Echo-RWN/RM_Guided_Dart/RM_Guided_Dart_Base_HW-SMT/RM_Guided_Dart_Base_HW-BOM.csv

 | Sourced | Placed | References | Value | Footprint | Quantity
1 |  |  | C5, C6, C12, C14, C15, C18, C19, C20, C24, C26, C31, C41, C42, C43, C45, C46, C47 | 100nF | C_0402_1005Metric | 17
2 |  |  | C11, C13, C16, C21, C22, C32, C33, C34, C38, C39, C40, C44 | 10uF | C_0603_1608Metric | 12
3 |  |  | C9, C10, C27, C28 | 22u | C_0603_1608Metric | 4
4 |  |  | C1, C2, C17 | 4.7u | C_0603_1608Metric | 3
5 |  |  | C35, C36, C37 | 22nF | C_0402_1005Metric | 3
6 |  |  | C3, C4 | 470n | C_0402_1005Metric | 2
7 |  |  | C7, C8 | 10n | C_0402_1005Metric | 2
8 |  |  | C29, C30 | 47uF | C_1206_3216Metric | 2
9 |  |  | C23 | 8.2nF | C_0402_1005Metric | 1
10 |  |  | C25 | 60pF | C_0402_1005Metric | 1
11 |  |  | R30, R32, R34, R35, R36, R37, R38, R41, R44 | 10k | R_0402_1005Metric | 9
12 |  |  | R1, R2, R3, R5, R7 | 33R | R_0402_1005Metric | 5
13 |  |  | R8, R9, R25, R27 | 100k | R_0402_1005Metric | 4
14 |  |  | R17, R39, R40 | 4.7k | R_0402_1005Metric | 3
15 |  |  | R18, R19, R20 | 50k | R_0402_1005Metric | 3
16 |  |  | R4, R23 | 1k | R_0402_1005Metric | 2
17 |  |  | R6, R42 | 33R | R_0603_1608Metric | 2
18 |  |  | R14, R16 | 5k | R_0402_1005Metric | 2
19 |  |  | R21, R22 | 300mR | R_0805_2012Metric | 2
20 |  |  | R10 | 200k±0.1% | R_0402_1005Metric | 1
21 |  |  | R11 | 27K±0.1% | R_0402_1005Metric | 1
22 |  |  | R12 | 68k±0.1% | R_0402_1005Metric | 1
23 |  |  | R13 | 15K±0.1% | R_0402_1005Metric | 1
24 |  |  | R15 | 24k/6.8k | R_0402_1005Metric | 1
25 |  |  | R24 | 3R | R_0402_1005Metric | 1
26 |  |  | R26 | 22k | R_0402_1005Metric | 1
27 |  |  | R28 | 50mR | R_0805_2012Metric | 1
28 |  |  | R29 | 11k | R_0402_1005Metric | 1
29 |  |  | R31 | 80k | R_0402_1005Metric | 1
30 |  |  | R33 | 20k | R_0402_1005Metric | 1
31 |  |  | R43 | 0R | R_0603_1608Metric | 1
32 |  |  | L1, L2 | 10uH | L_Changjiang_FTC303020D | 2
33 |  |  | L3 | 10uH | L_APV_APH0630 | 1
34 |  |  | L4 | 3.3uH | L_APV_APH0630 | 1
35 |  |  | D1, D2, D4 | G | LED_0402_1005Metric | 3
36 |  |  | D5, D6 | R | LED_0402_1005Metric | 2
37 |  |  | D3 | SS54 | D_SMA | 1
38 |  |  | D7 | SS34 | D_SMA | 1
39 |  |  | D8 | BV03C | D_SOD-323 | 1
40 |  |  | U3, U4 | SY8303AIC | TSOT-23-8 | 2
41 |  |  | U1 | LicheeRV_Nano | LicheeRV_Nano_THT | 1
42 |  |  | U2 | XIAO-ESP32-C5-DIP | XIAO-ESP32-C5-SMD | 1
43 |  |  | U5 | CH224Q | DFN-10-1EP_2x2mm_P0.4mm_EP0.9x1.5mm | 1
44 |  |  | U6 | TP5100 | QFN-16-1EP_4x4mm_P0.65mm_EP2.1x2.1mm_ThermalVias | 1
45 |  |  | U7 | TPS54620RHLR | VQFN-14_L3.5-W3.5-P0.50-TL-EP_TPS54620RHLR | 1
46 |  |  | U8 | RT9193-18GB | SOT-23-5 | 1
47 |  |  | U9 | RT9193-15GB | SOT-23-5 | 1
48 |  |  | U10 | RT9193-28GB | SOT-23-5 | 1
49 |  |  | U11 | BMI088 | Bosch_LGA-16_4.5x3mm_P0.5mm_LayoutBorder7x1y_ClockwisePinNumbering | 1
50 |  |  | SW1 | SW_Push | SW_Tactile_SPST_NO_Straight_CK_PTS636Sx25SMTRLFS | 1
51 |  |  | SW2 | SW_Push_DPDT | SW_E-Switch_EG1271_SPDT | 1
52 |  |  | Q1, Q2 | AON7403 | Vishay_PowerPAK_1212-8_Single | 2
53 |  |  | J4, J9 | PWM4 | Connector_Servo_JR_3P_2.54mm_WirePad | 2
54 |  |  | J1 | CSI | FPC-SMD_22P-P1.00_AFC11-S22ICC-00 | 1
55 |  |  | J2 | DSI | Hirose_FH26-31S-0.3SHW_2Rows-31Pins-1MP_P0.60mm_Horizontal | 1
56 |  |  | J3 | JTAG | JST_GH_SM06B-GHS-TB_1x06-1MP_P1.25mm_Horizontal | 1
57 |  |  | J5 | UART3 | JST_GH_SM04B-GHS-TB_1x04-1MP_P1.25mm_Horizontal | 1
58 |  |  | J6 | PWM1 | Connector_Servo_JR_3P_2.54mm_WirePad | 1
59 |  |  | J7 | PWM2 | Connector_Servo_JR_3P_2.54mm_WirePad | 1
60 |  |  | J8 | PWM3 | Connector_Servo_JR_3P_2.54mm_WirePad | 1
61 |  |  | J10 | USB_C_Receptacle_USB2.0_14P | USB-C-TH_KH-TYPE-C-W-16P-T | 1
62 |  |  | J11 | Battery | AMASS_XT30APW-M_1x02_P2.50mm_Horizontal | 1
63 |  |  | J12 | camera | FH12-24S-0.5SH_1x24-1MP_P0.50mm_Horizontal | 1
