Echo-RWN/RM_Guided_Dart/RM_Guided_Dart_Base_HW-Battery.pdf

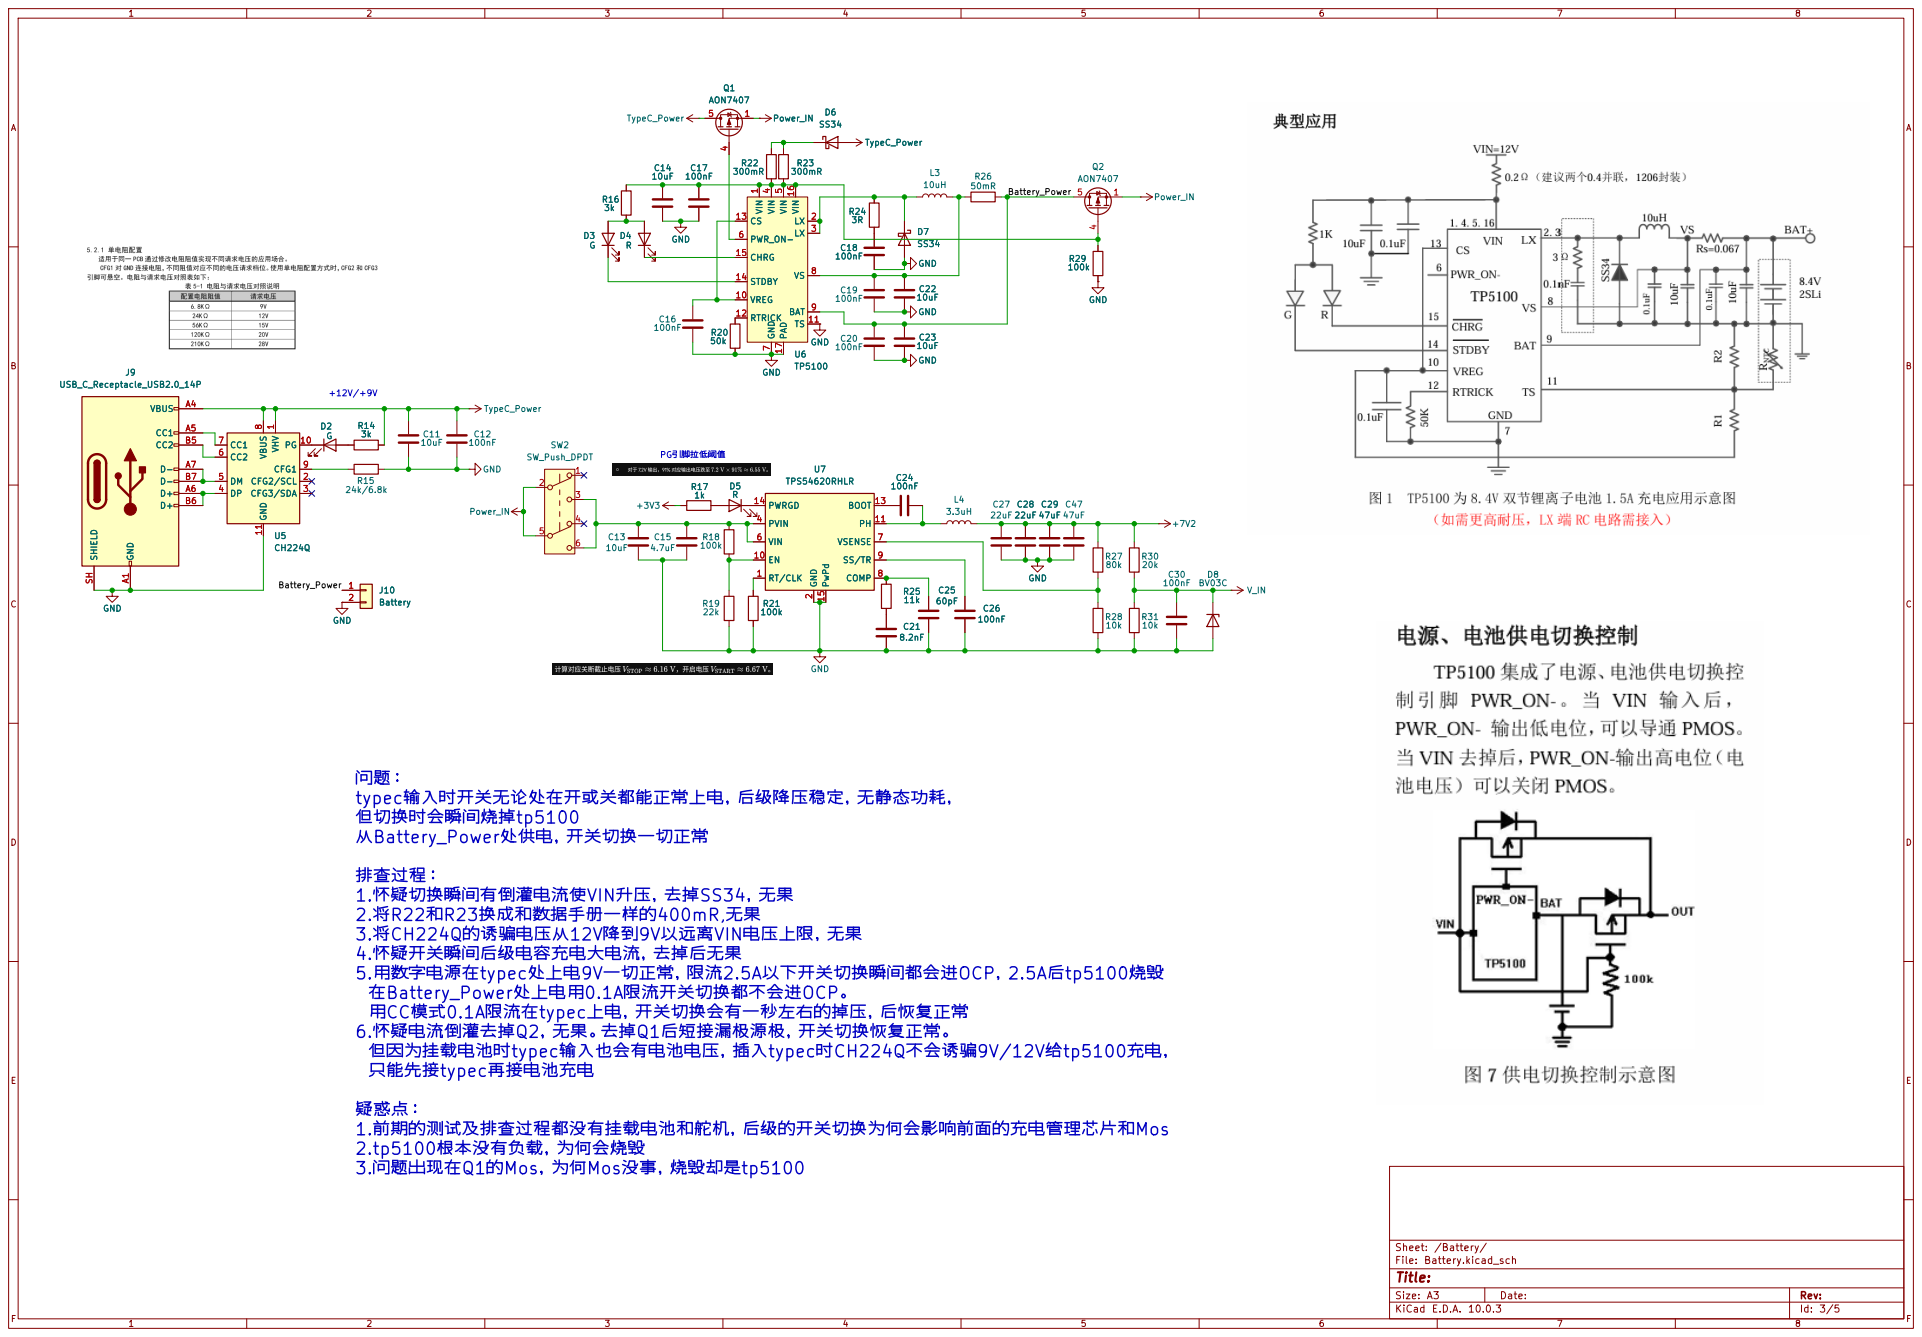
[picture p1: page 1]

Size: A3 | Rev: | F Date:
KiCad E.D.A. 10.0.3 | Id: 3/5
