Echo-RWN/RM_Guided_Dart/(commit log)

2026-09-05 feat: init RM_Guided_Dart_Base_HW project
    [RM_Guided_Dart_Base_HW.kicad_pcb, RM_Guided_Dart_Base_HW.kicad_sch]
2026-09-05 feat: add camera power schematic, ignore kicad local history
    [RM_Guided_Dart_Base_HW.kicad_sch]
2026-09-22 hardware: complete schematic & PCB layout ready for fabrication
    [Battery.kicad_sch, Camera.kicad_sch, IMU.kicad_sch, Power.kicad_sch, RM_Guided_Dart_Base_HW-BOM.csv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]
2026-09-22 hardware: update design files ready for tapeout
    [RM_Guided_Dart_Base_HW-BOM.csv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]
2026-09-25 hardware: update design and tapeout for fabrication
    [Battery.kicad_sch, Camera.kicad_sch, IMU.kicad_sch, Power.kicad_sch, RM_Guided_Dart_Base_HW-BOM.csv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]
2026-10-15 V1.2已打板
    [Battery.kicad_sch, Camera.kicad_sch, IMU.kicad_sch, Power.kicad_sch, RM_Guided_Dart_Base_HW-BOM.csv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]
